rOzzy1987/moron-i3/Doc/Blind.png

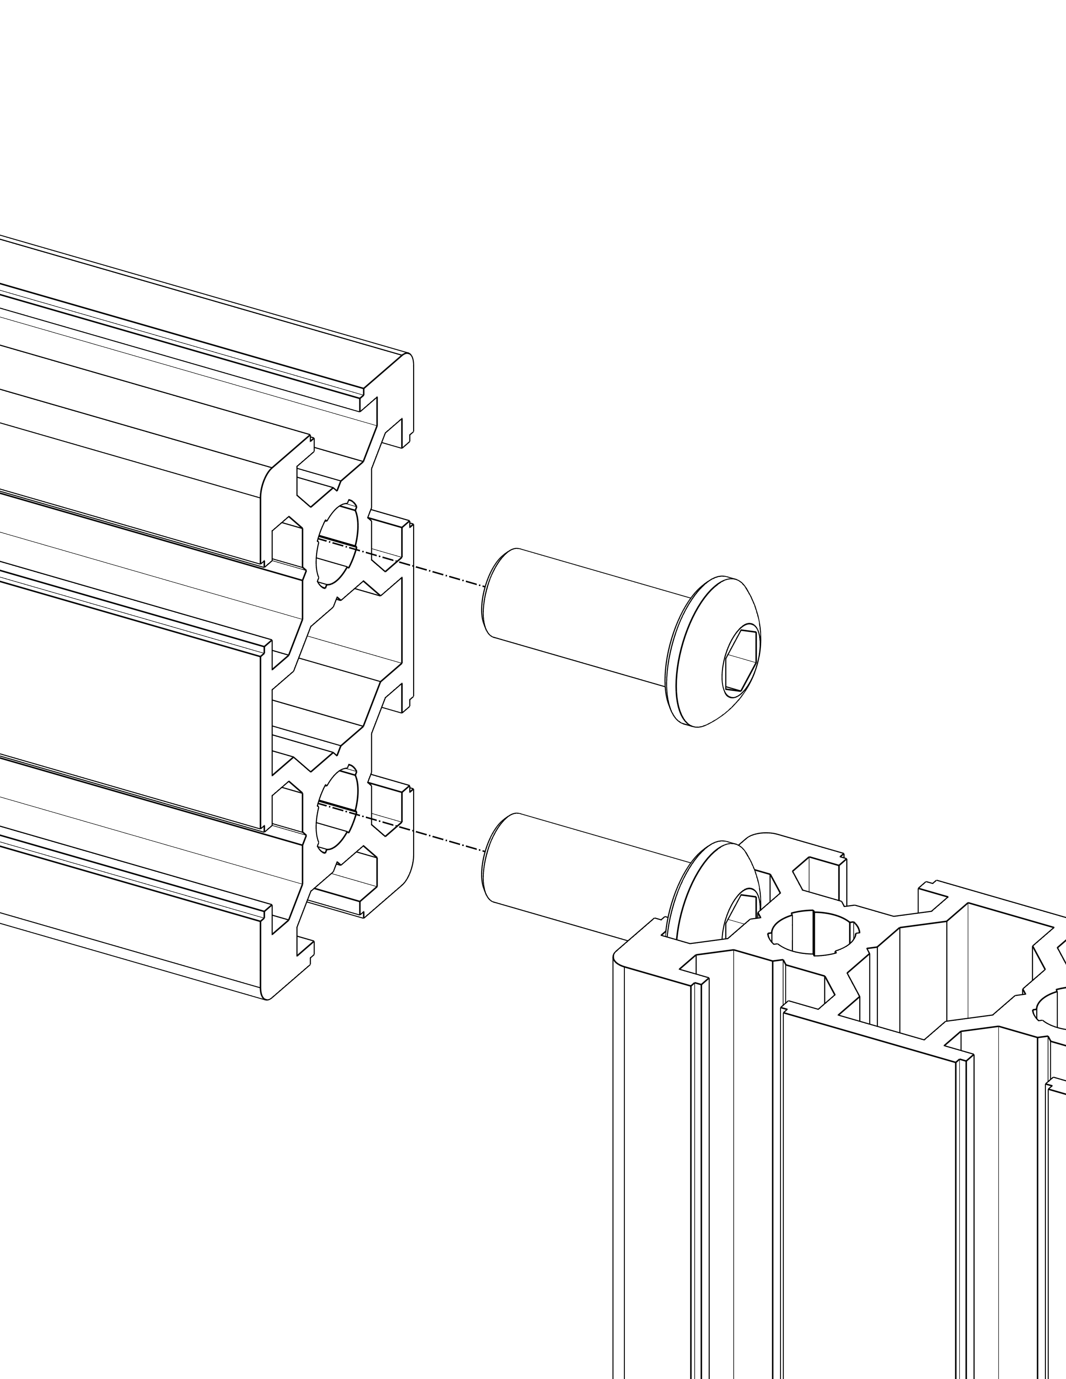
Doc/Blind.png
