rOzzy1987/moron-i3/Doc/IEC_socket.jpg

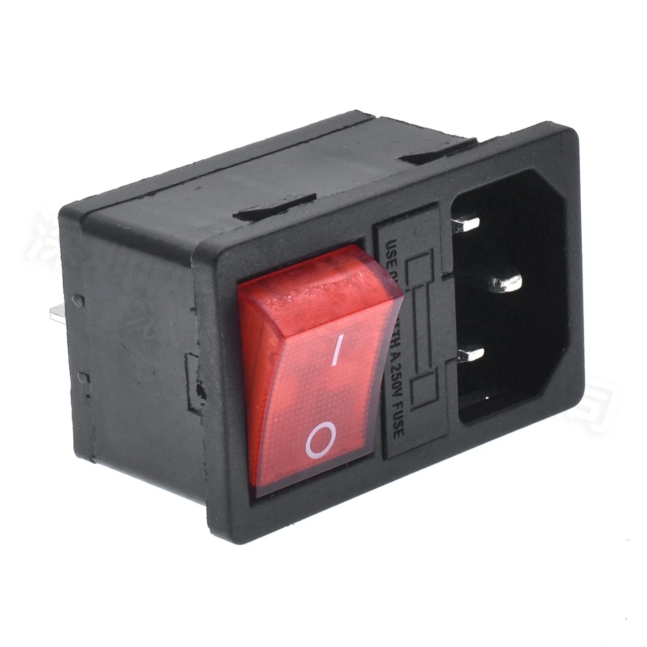
Doc/IEC_socket.jpg
