rOzzy1987/moron-i3/Doc/BOM.md

| Quantity | Name | Category  | Note |
|---:|---|---|---|
| 1 | 2040-300 | Extrusion | Refer to drawings in the assembly section |
| 2 | 2040-300-Bottom | Extrusion | |
| 2 | 2040-400-Horizontal | Extrusion | |
| 2 | 2040-400-Vertical | Extrusion | |
| 3 | BHCS-M4x6 | Fastener  | Button head cap screw (DIN9427) |
| 12 | BHCS-M6x15 | Fastener  | |
| 4 | BHCS-M6x30 | Fastener  | |
| 11 | M3x4x5 Heat Set Insert | Fastener  | "Voron style" inserts |
| 30 | Nut-M3 | Fastener  | |
| 2 | Washer-M3 | Fastener  | |
| 2 | SHCS-M3x10 | Fastener  | Socket head cap screw (DIN912) |
| 4 | SHCS-M3x10 | Fastener  | |
| 6 | SHCS-M3x12 | Fastener  | |
| 1 | SHCS-M3x16 | Fastener  | |
| 8 | SHCS-M3x20 | Fastener  | |
| 5 | SHCS-M3x25 | Fastener  | |
| 4 | SHCS-M3x30 | Fastener  | |
| 22 | SHCS-M3x8 | Fastener  | |
| 47 | SHCS-M4x8 | Fastener  | |
| 47 | T-Nut-M4 | Fastener  | |
| 1 | AC Box | Printed | |
| 1 | Control Box | Printed | |
| 1 | Control Box Lid | Printed | |
| 1 | Dragonburner Mount | Printed | |
| 1 | Nozzle Brush Holder | Printed | |
| 1 | PSU Mount | Printed | |
| 1 | Spool Holder | Printed | |
| 1 | X Belt Tensioner | Printed | |
| 1 | X Carriage | Printed | |
| 1 | X Drag Chain Fixed | Printed | |
| 1 | X Drag Chain Mount | Printed | |
| 1 | X Gantry L | Printed | |
| 1 | X Gantry R | Printed | |
| 1 | Y Bed Carriage | Printed | |
| 1 | Y Belt Clip | Printed | |
| 1 | Y Belt Clip Cap | Printed | |
| 1 | Y Motor Holder | Printed | |
| 4 | Y Rod Holder | Printed | |
| 1 | Y Tensioner Arm | Printed | |
| 1 | Y Tensioner Base | Printed | |
| 1 | Z Motor Mount L | Printed | |
| 1 | Z Motor Mount R | Printed | |
| 1 | Z Rod Holder L | Printed | |
| 1 | Z Rod Holder R | Printed | |
| 1 | 220x200 MK3 Heated Bed | Sourced | |
| 2 | 2GT 20 Teeth Idler | Sourced | With 3mm ID bearings |
| 2 | 2GT 20 Teeth Wheel | Sourced | |
| 2 | 2GT belt ~1m | Sourced | Will need to trim to length as you go |
| 2 | 2x4mm PTFE Tube - 75mm | Sourced | |
| 1 | 7x7mm closed drag chain | Sourced | |
| 2 | 8mm Linear Axis - 325mm | Sourced | |
| 2 | 8mm Linear Axis - 350mm | Sourced | Length here is not critical, but at least 340mm |
| 2 | 8mm Linear Axis - 410mm | Sourced | Length also not critical, between 410mm and 450mm is fine |
| 2 | 8mm To 5mm Shaft Coupler | Sourced | |
| 2 | Bambulab silicone nozzle brush | Sourced | |
| 4 | Bed adjuster nuts | Sourced | |
| 4 | Bed Springs | Sourced | |
| 1 | IEC C14 Panel mount connector | Sourced | The rectangular kind with a fuse and a switch like [this](IEC_Socket.png) |
| 12 | LM8UU Linear Bearing | Sourced | |
| 1 | LRS-350-24 PSU | Sourced | Creality or MeanWell preferred |
| 4 | Nema17 Stepper | Sourced | |
| 4 | Rubber Foot - 20x12mm | Sourced | Obviously change to whatever you like |
| 2 | T8 Leadscrew - 300mm | Sourced | |
| 2 | T8 Leadscrew Nut | Sourced | |
| 20? | Zip ties | Sourced | For fixing wires and the bed's linear bearings. A pack of 3x150mm is good |
| 1 | Mellow FLY D5 Control board | Control | Or any other board, but the control box is designed for this | |
| 1 | Raspberry Pi form factor host computer | Control | I used a Mellow FLY Pi V2 with an M2WE SSD + Wifi |
| 1 | Self sourced toolhead | Control | I used a Dragon burner with TZ3.0 hotend, and RHGX Extruder |
