rOzzy1987/moron-i3/CAD/X Gantry R.step

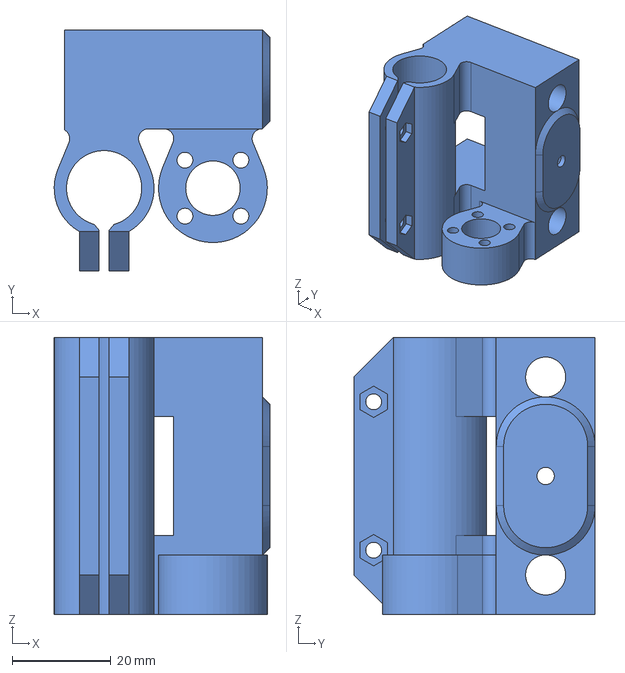
[picture p4: CAD file, 2025-08-10]
CAD/X Gantry R.step
43.6 x 48.8 x 56.0 mm
