rOzzy1987/moron-i3/CAD/Y Rod holder.step

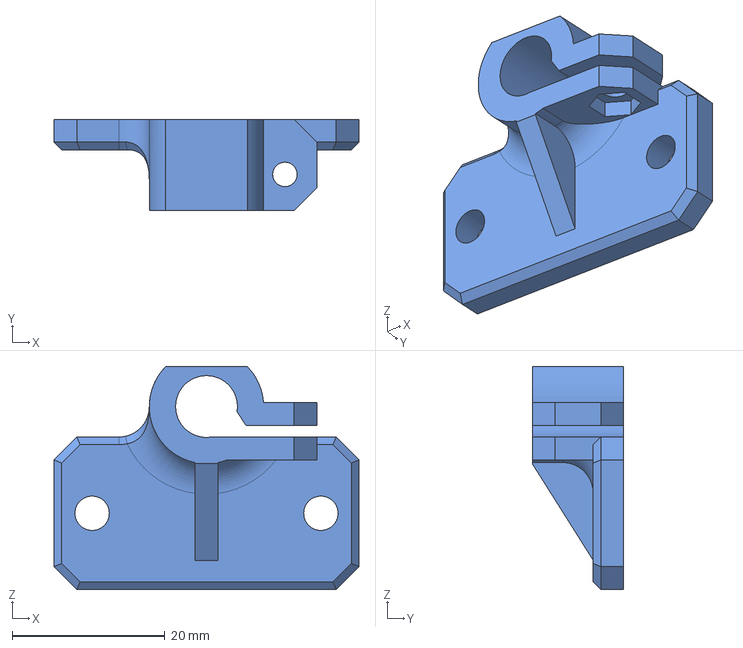
[picture p5: CAD file, 2025-08-10]
CAD/Y Rod holder.step
40.0 x 12.0 x 29.2 mm
