rOzzy1987/moron-i3/CAD/AC Box.step

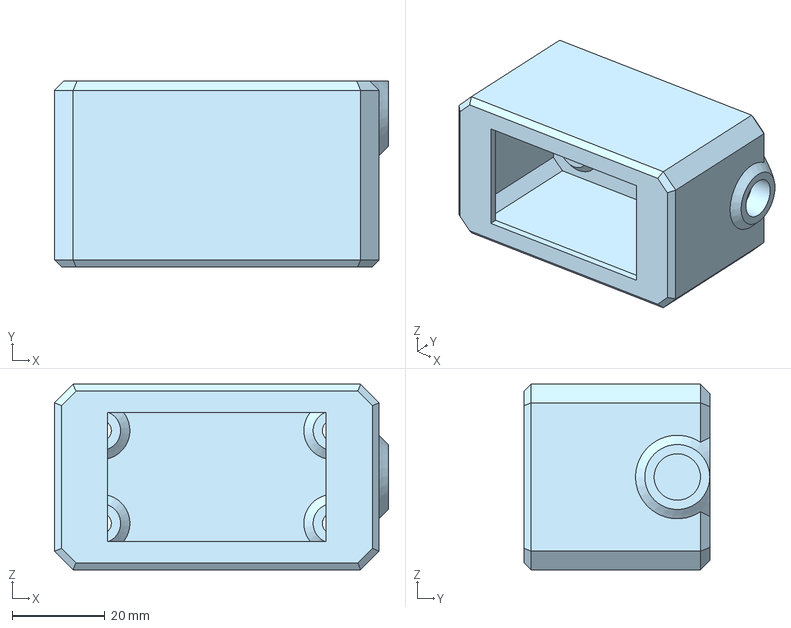
[picture p6: CAD file, 2025-08-10]
CAD/AC Box.step
72.0 x 40.0 x 40.0 mm
