rOzzy1987/moron-i3/CAD/Z Rod Holder L.step

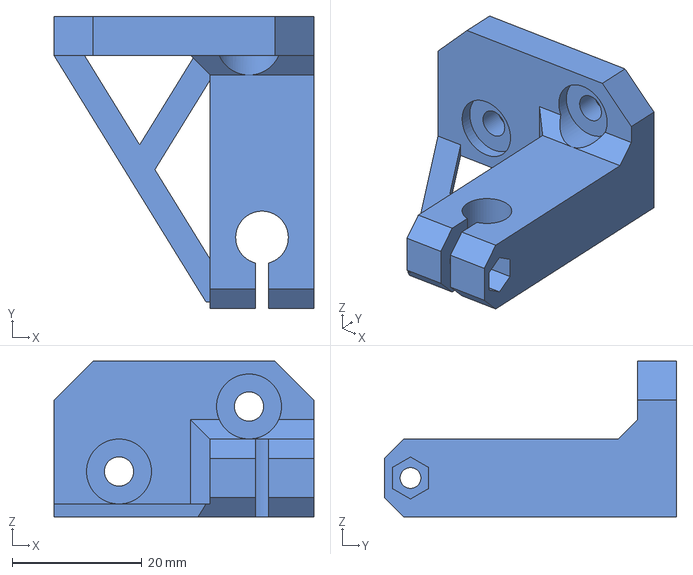
[picture p7: CAD file, 2025-08-10]
CAD/Z Rod Holder L.step
40.0 x 44.9 x 24.0 mm
