rOzzy1987/moron-i3/CAD/X Carriage.step

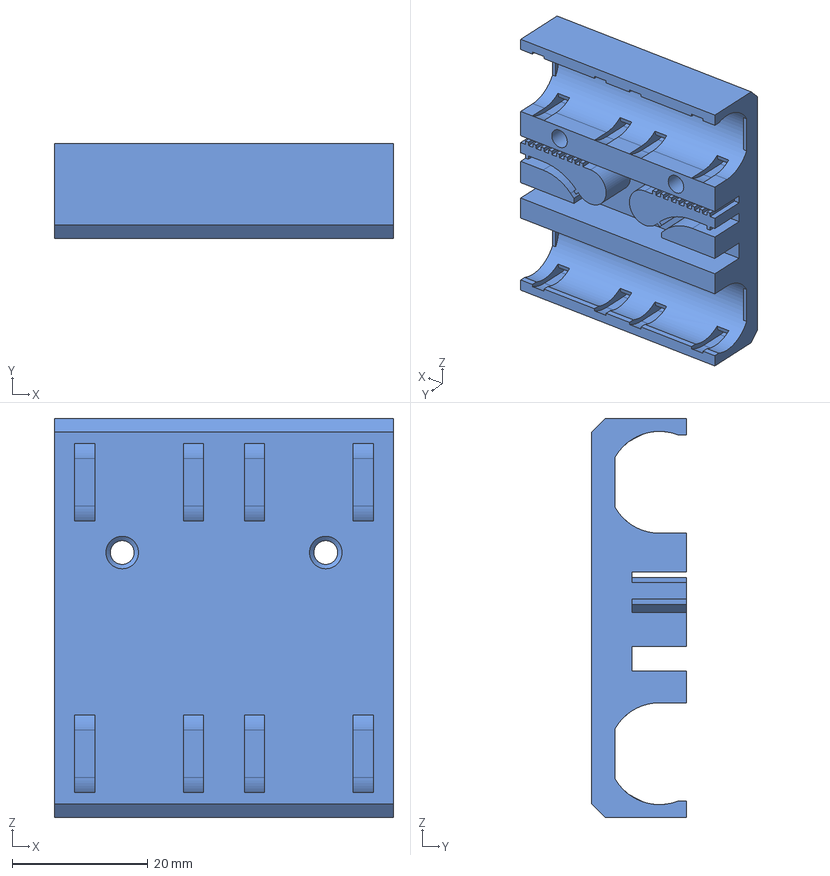
[picture p8: CAD file, 2025-08-10]
CAD/X Carriage.step
50.0 x 14.0 x 58.8 mm
