rOzzy1987/moron-i3/CAD/Z Drag Chain mount.step

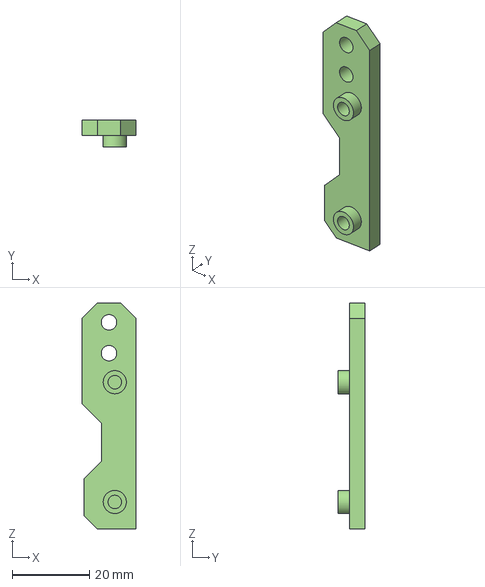
[picture p9: CAD file, 2025-08-10]
CAD/Z Drag Chain mount.step
14.0 x 7.00 x 58.5 mm
