rOzzy1987/moron-i3/CAD/Control Box.step

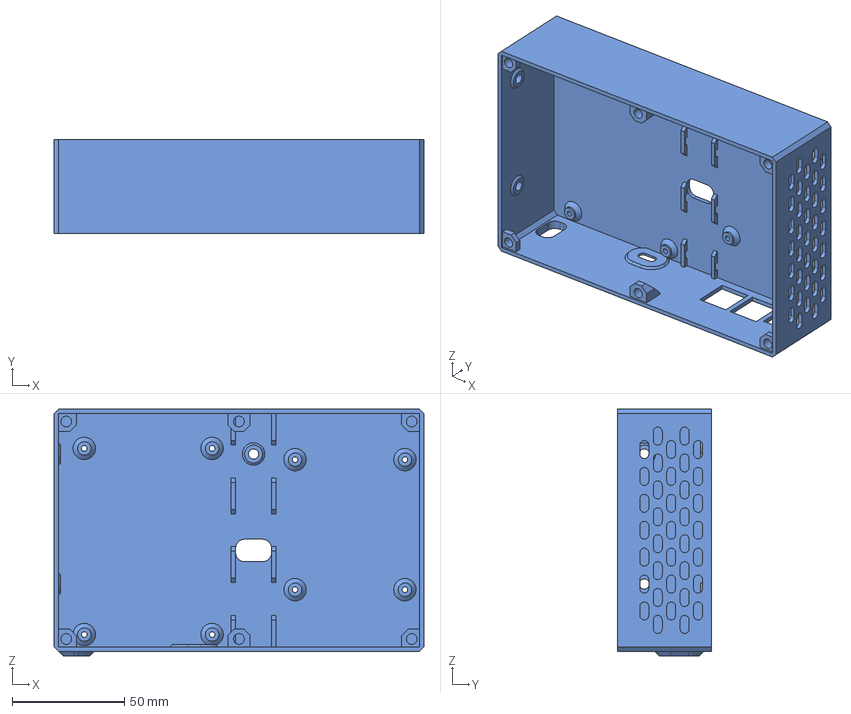
[picture p10: CAD file, 2025-08-10]
CAD/Control Box.step
165.0 x 42.0 x 110.0 mm
