rOzzy1987/moron-i3/CAD/Y Belt Clip Cap.step

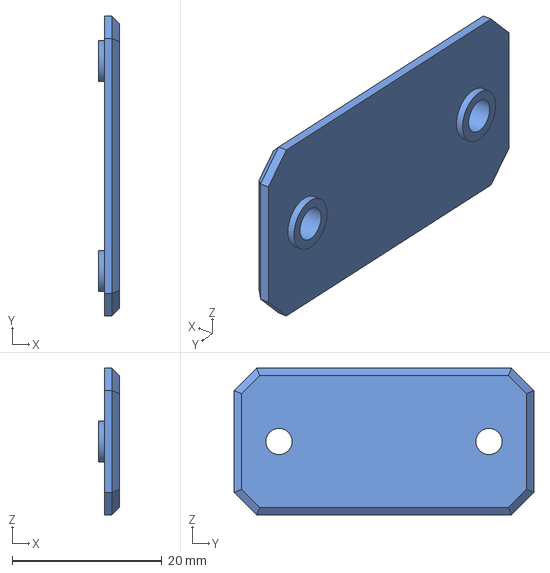
[picture p11: CAD file, 2025-08-10]
CAD/Y Belt Clip Cap.step
2.80 x 40.0 x 19.6 mm
