rOzzy1987/moron-i3/CAD/X Dragonburner mount.step

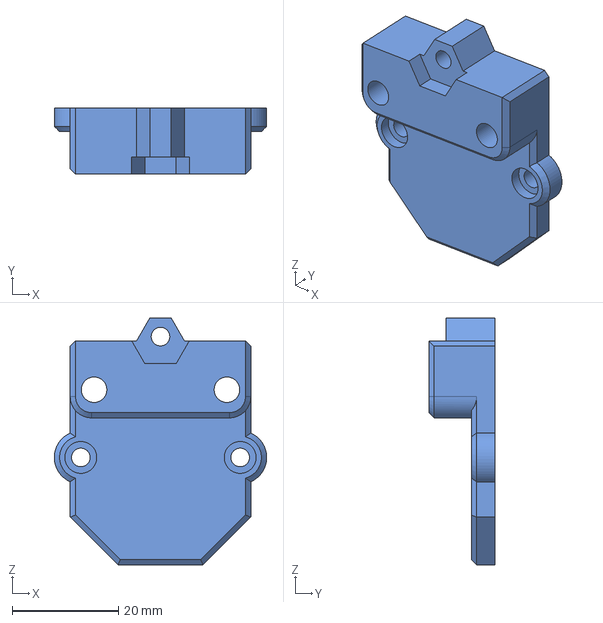
[picture p12: CAD file, 2025-08-10]
CAD/X Dragonburner mount.step
40.0 x 12.5 x 46.5 mm
