rOzzy1987/moron-i3/CAD/Z Motor Mount R.step

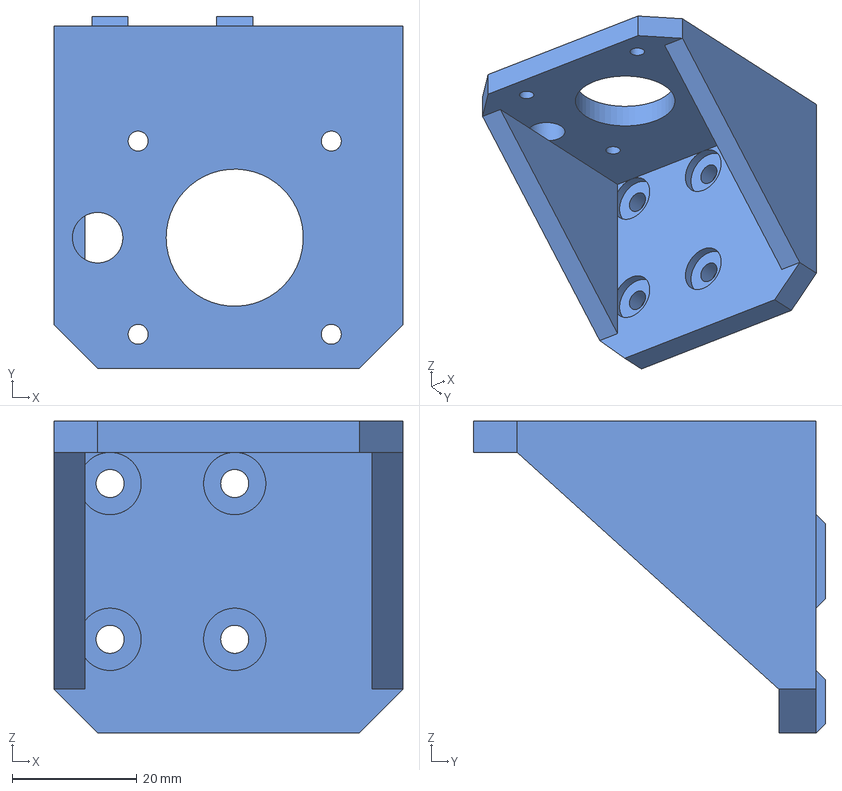
[picture p13: CAD file, 2025-08-10]
CAD/Z Motor Mount R.step
56.0 x 56.5 x 50.0 mm
