rOzzy1987/moron-i3/CAD/PSU Mount.step

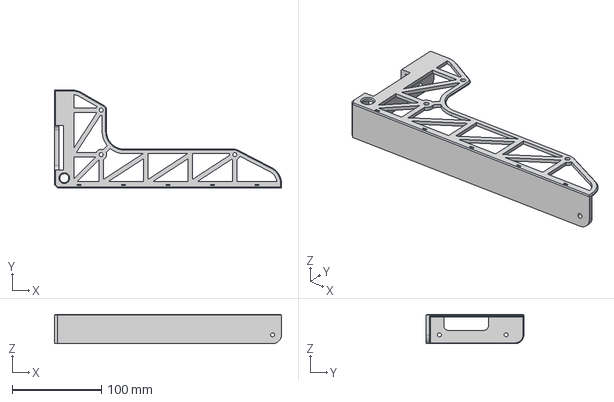
[picture p14: CAD file, 2025-08-10]
CAD/PSU Mount.step
255.0 x 110.0 x 33.0 mm
