rOzzy1987/moron-i3/CAD/X Gantry L.step

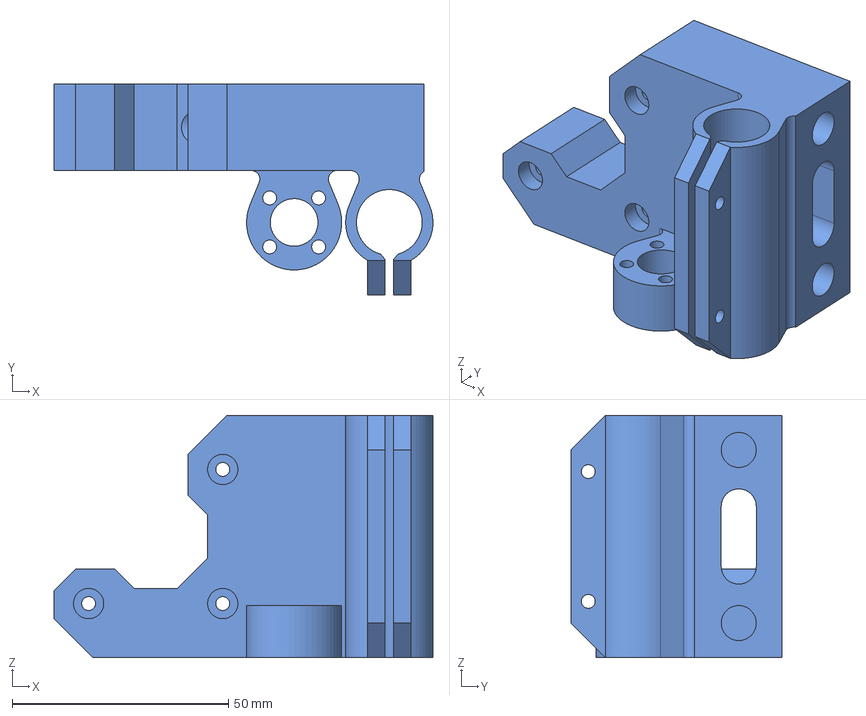
[picture p15: CAD file, 2025-08-10]
CAD/X Gantry L.step
87.6 x 48.8 x 56.0 mm
