rOzzy1987/moron-i3/CAD/Z Drag Chain Fixed.step

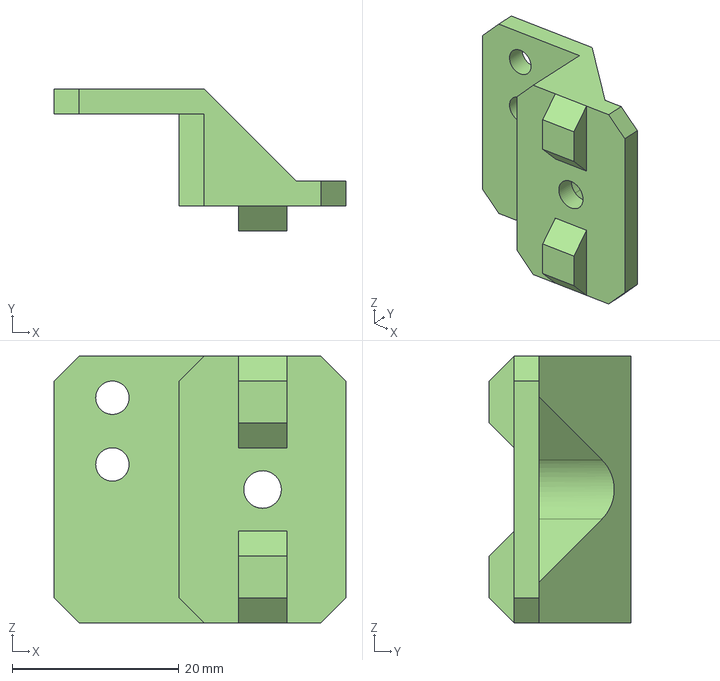
[picture p16: CAD file, 2025-08-10]
CAD/Z Drag Chain Fixed.step
35.0 x 17.0 x 32.0 mm
