rOzzy1987/moron-i3/CAD/Control Box Lid.step

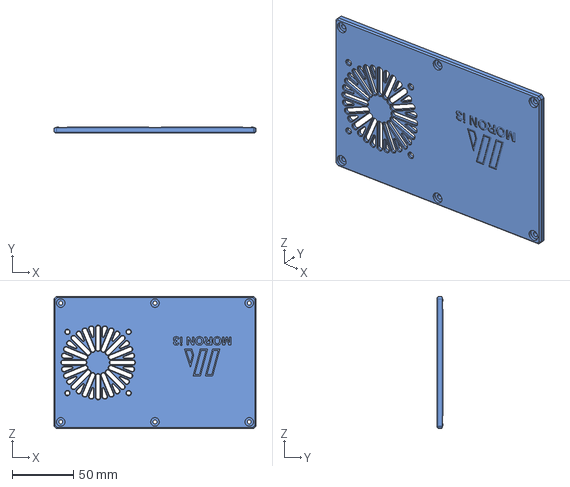
[picture p17: CAD file, 2025-08-10]
CAD/Control Box Lid.step
165.0 x 5.00 x 108.0 mm
