rOzzy1987/moron-i3/CAD/Nozzle brush holder.step

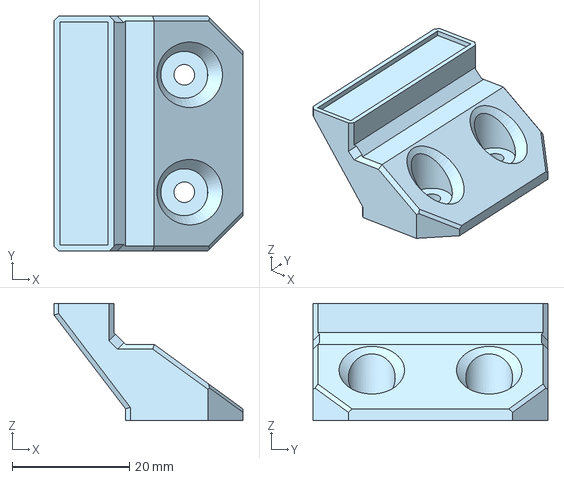
[picture p18: CAD file, 2025-08-10]
CAD/Nozzle brush holder.step
32.2 x 40.0 x 20.0 mm
