rOzzy1987/moron-i3/CAD/Y Bed Carriage.step

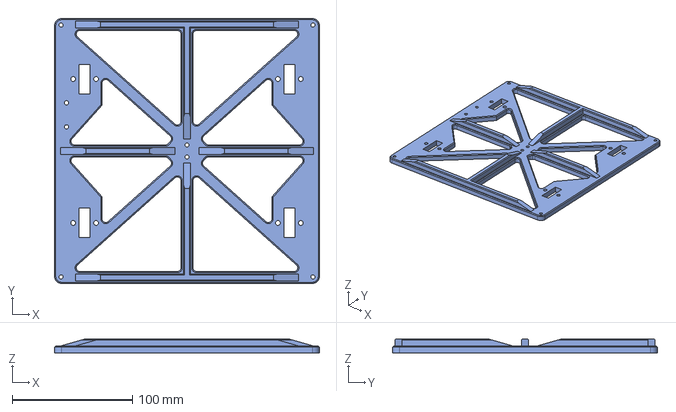
[picture p19: CAD file, 2025-08-10]
CAD/Y Bed Carriage.step
220.0 x 220.0 x 12.0 mm
