rOzzy1987/moron-i3/CAD/X Belt Tensioner.step

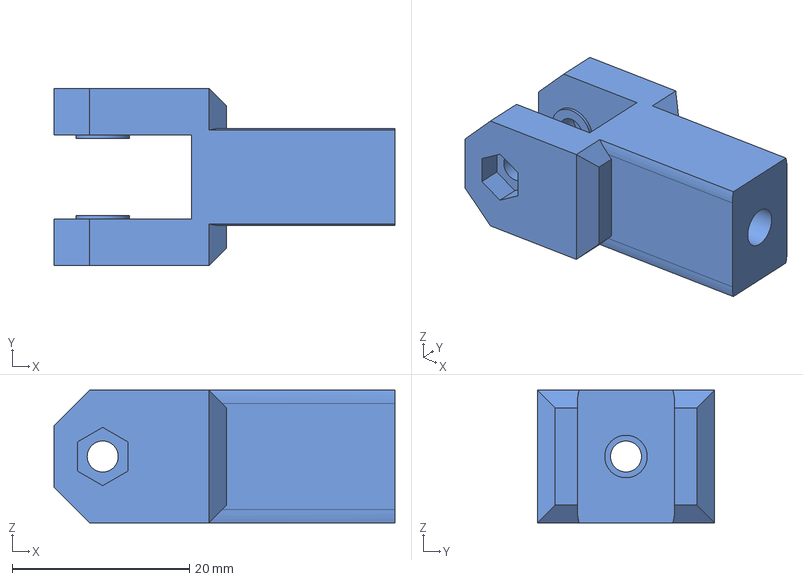
[picture p20: CAD file, 2025-08-10]
CAD/X Belt Tensioner.step
38.5 x 20.0 x 15.0 mm
