rOzzy1987/moron-i3/CAD/Y Belt Clip.step

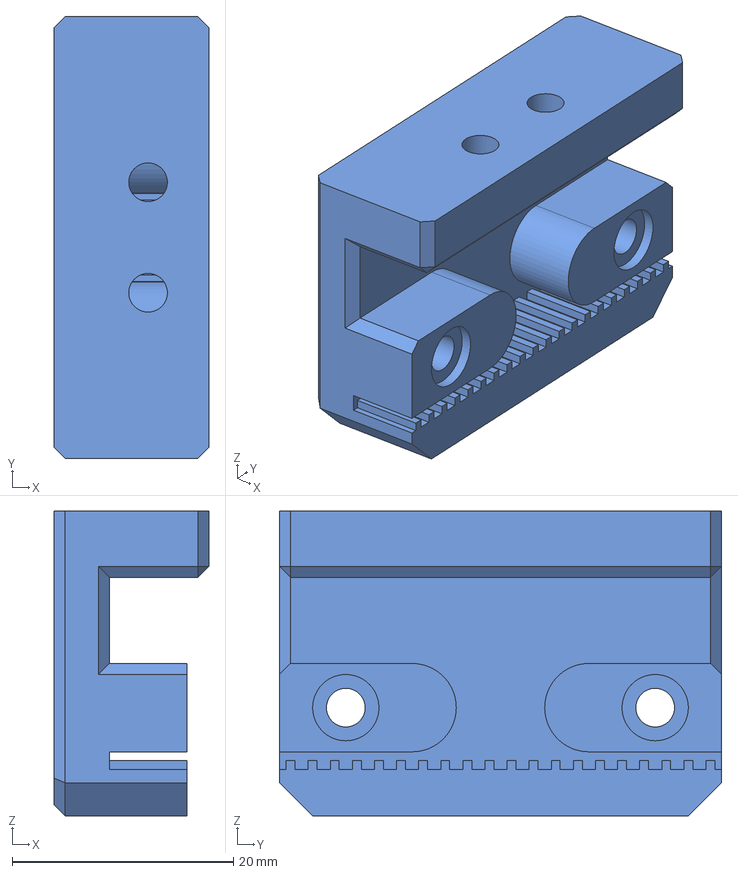
[picture p21: CAD file, 2025-08-10]
CAD/Y Belt Clip.step
14.0 x 40.0 x 27.6 mm
