rOzzy1987/moron-i3/CAD/Y Motor Holder.step

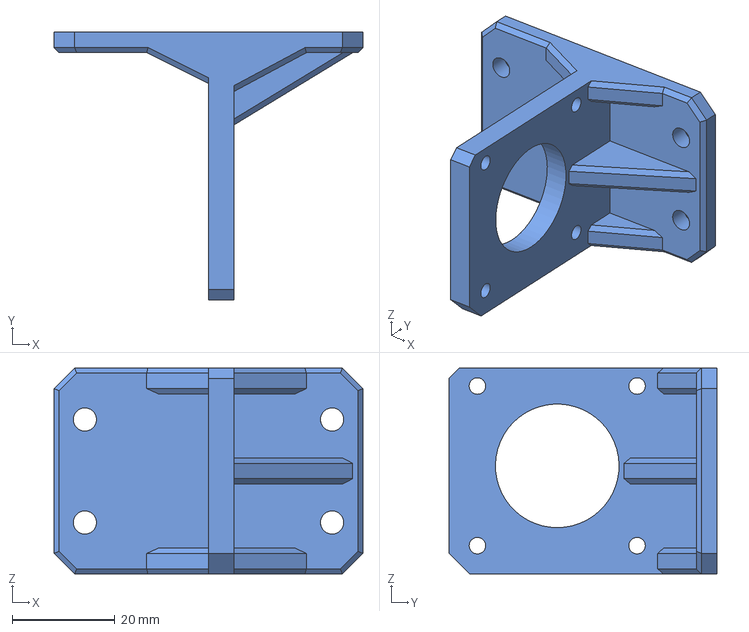
[picture p22: CAD file, 2025-08-10]
CAD/Y Motor Holder.step
60.0 x 52.0 x 40.0 mm
