rOzzy1987/moron-i3/CAD/Y Tensioner Arm.step

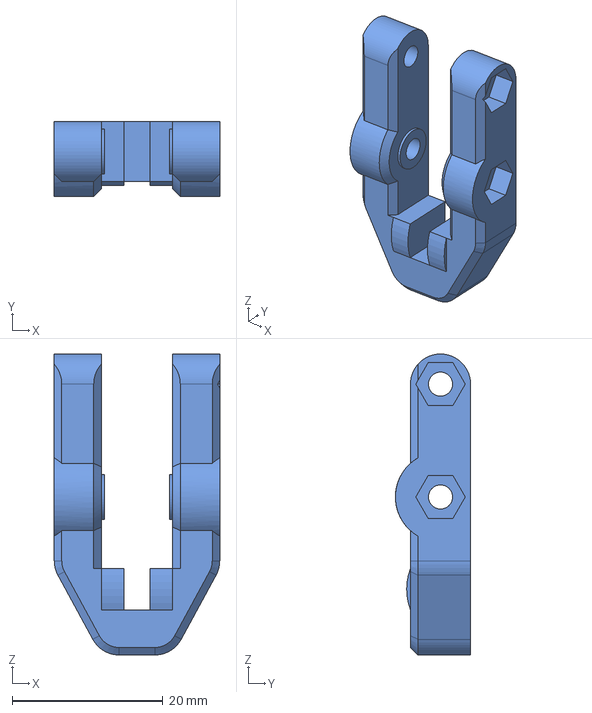
[picture p23: CAD file, 2025-08-10]
CAD/Y Tensioner Arm.step
22.0 x 10.0 x 40.0 mm
