rOzzy1987/moron-i3/CAD/Y Tensioner base.step

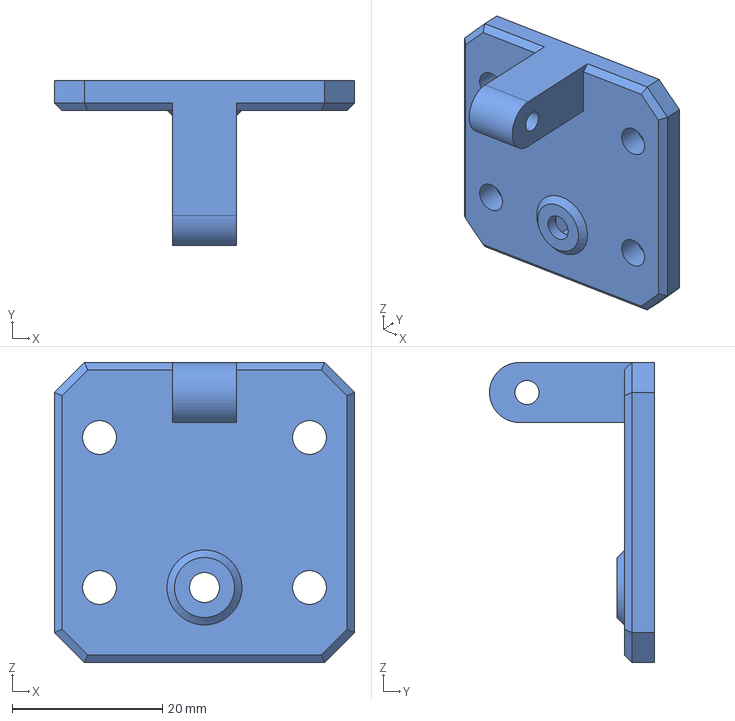
[picture p24: CAD file, 2025-08-10]
CAD/Y Tensioner base.step
40.0 x 22.0 x 40.0 mm
