rOzzy1987/moron-i3/(list of files, cad)

Other CAD files:
CAD/Z Rod Holder R.step
CAD/Z Motor Mount L.step
STL/AC Box.stl
STL/Control Box Lid.stl
STL/Control Box.stl
STL/Nozzle brush holder.stl
STL/PSU Mount.stl
STL/X Belt Tensioner.stl
STL/X Carriage.stl
STL/X Dragonburner mount.stl
STL/X Gantry L.stl
STL/X Gantry R.stl
STL/Y Bed Carriage.stl
STL/Y Belt Clip Cap.stl
STL/Y Belt Clip.stl
STL/Y Motor Holder.stl
STL/Y Rod holder.stl
STL/Y Tensioner Arm.stl
STL/Y Tensioner base.stl
STL/Z Drag Chain Fixed.stl
STL/Z Drag Chain mount.stl
STL/Z Motor Mount L.stl
STL/Z Motor Mount R.stl
STL/Z Rod Holder L.stl
STL/Z Rod Holder R.stl
